TeiTeijin/EMF-Wire-Fault-Detector/firmware/EMF_Wire_Fault_Detector_v13/README.md

# Superseded firmware

This sketch version is kept for history only. It is **superseded by
[`EMF_Wire_Fault_Detector_v14`](../EMF_Wire_Fault_Detector_v14/)** —
do not flash this version.
