TeiTeijin/EMF-Wire-Fault-Detector/docs/erd.png

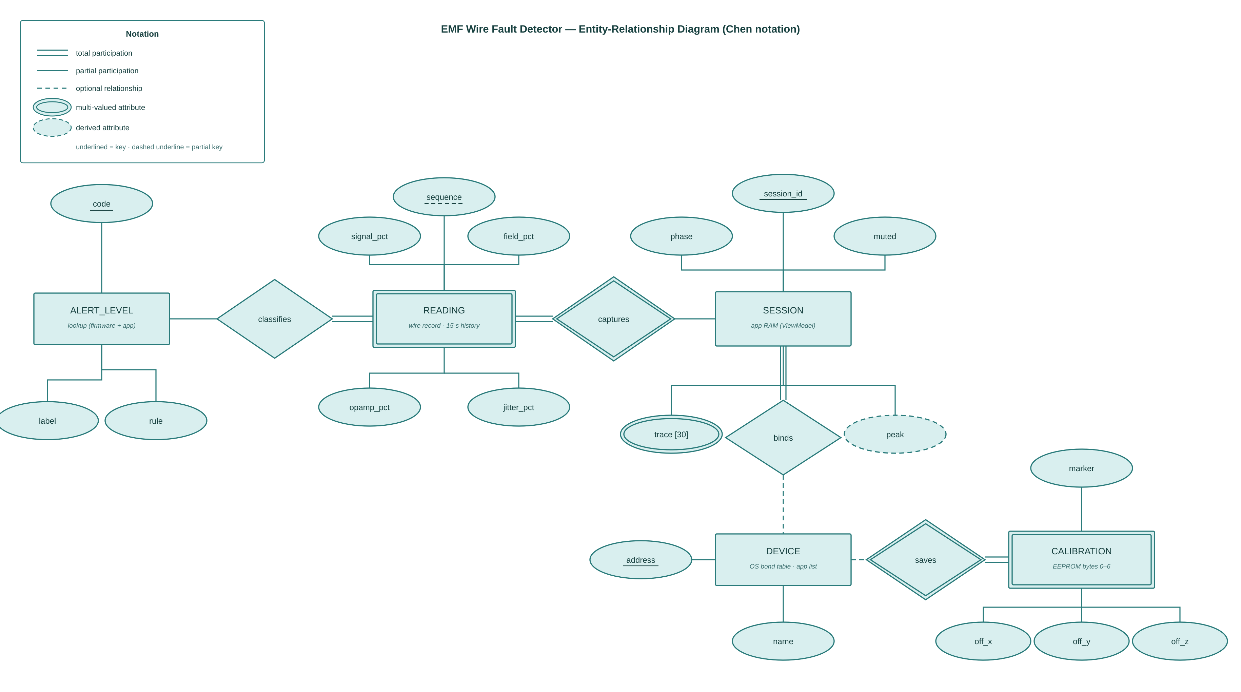
docs/erd.png
