TeiTeijin/EMF-Wire-Fault-Detector/docs/flowchart-firmware.png

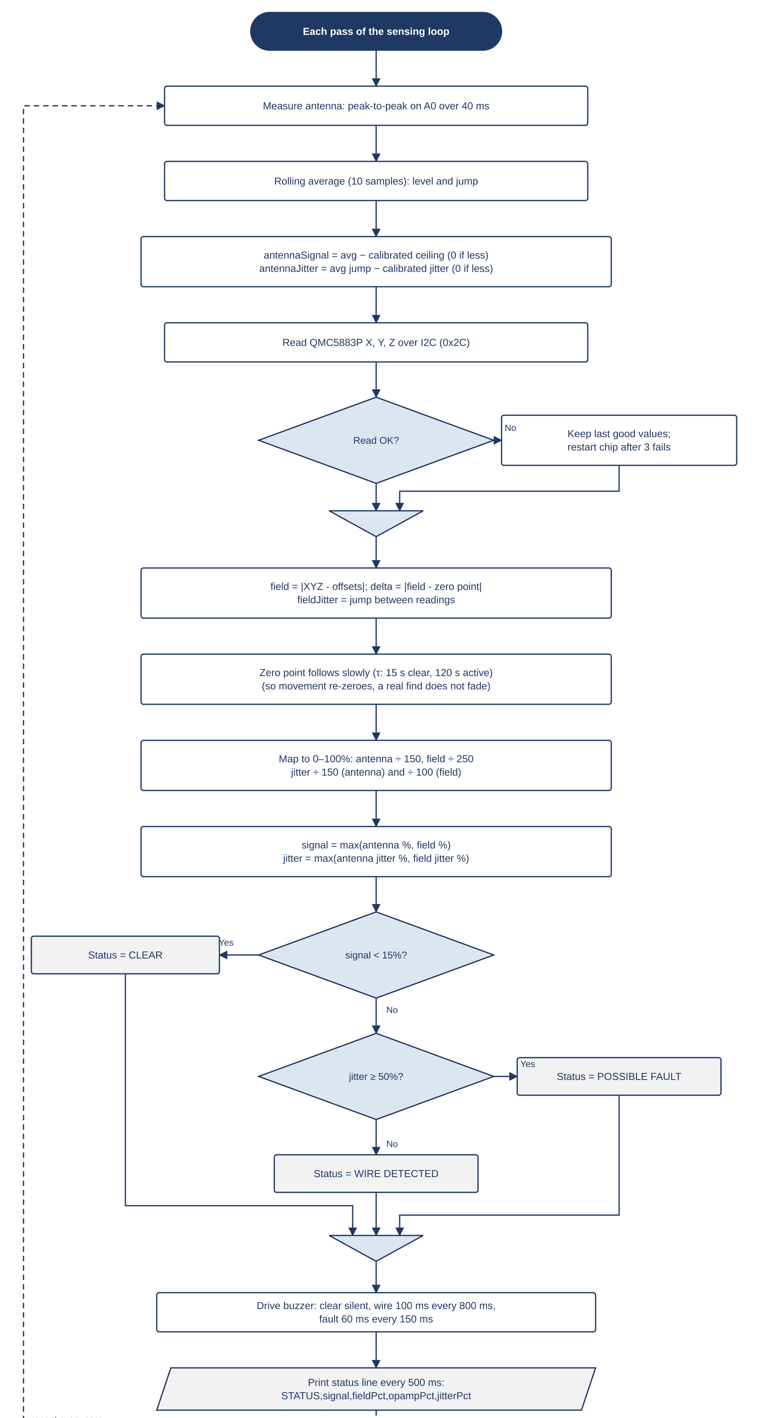
docs/flowchart-firmware.png
