TeiTeijin/EMF-Wire-Fault-Detector/docs/flowchart.png

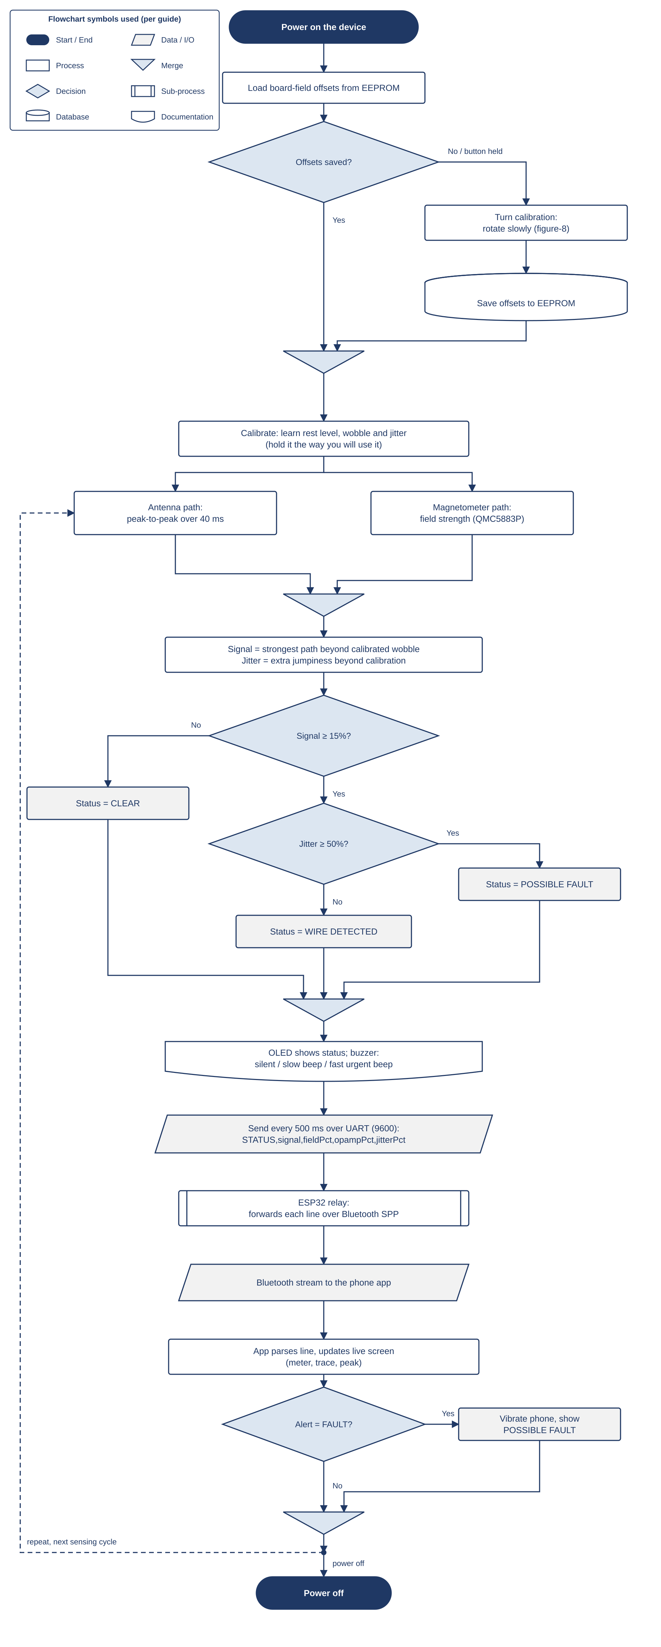
docs/flowchart.png
