TeiTeijin/EMF-Wire-Fault-Detector/docs/screenshots/01-bluetooth-access.png

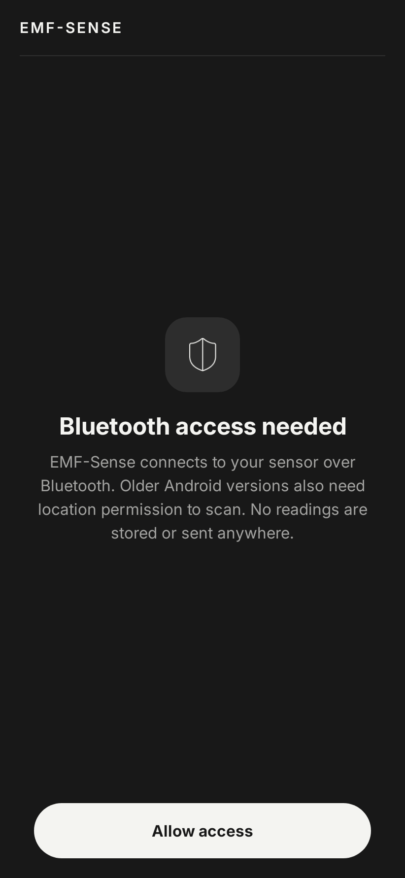
docs/screenshots/01-bluetooth-access.png
