TeiTeijin/EMF-Wire-Fault-Detector/docs/screenshots/02-bluetooth-denied.png

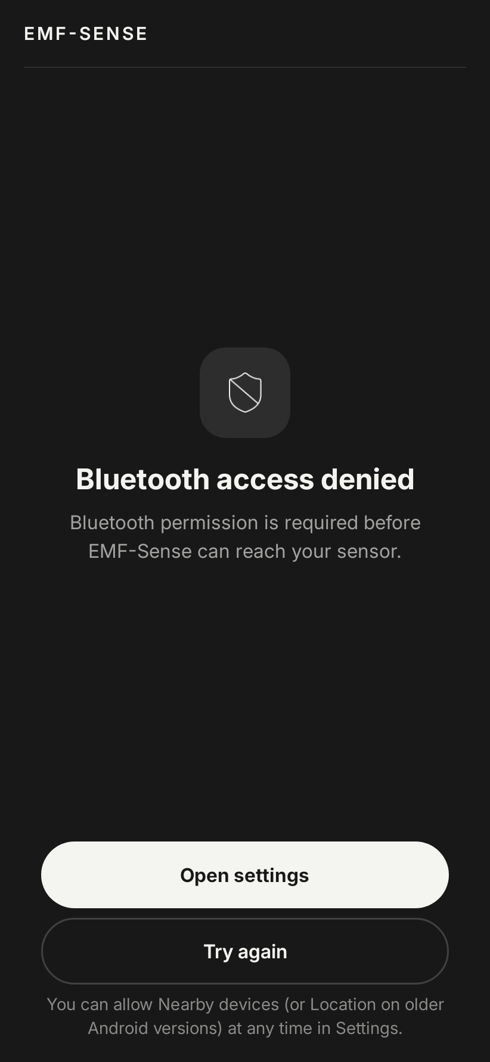
docs/screenshots/02-bluetooth-denied.png
