TeiTeijin/EMF-Wire-Fault-Detector/docs/screenshots/03-scan-loading.png

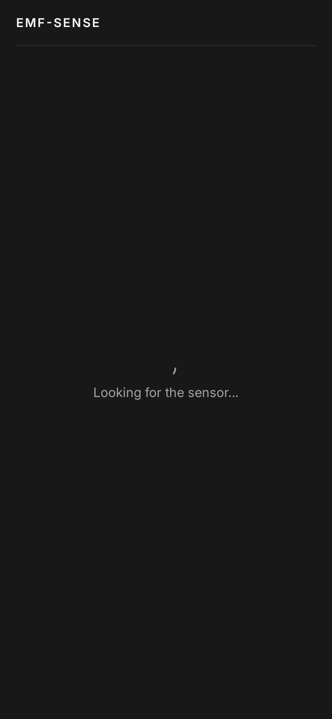
docs/screenshots/03-scan-loading.png
