TeiTeijin/EMF-Wire-Fault-Detector/docs/screenshots/04-scan-found.png

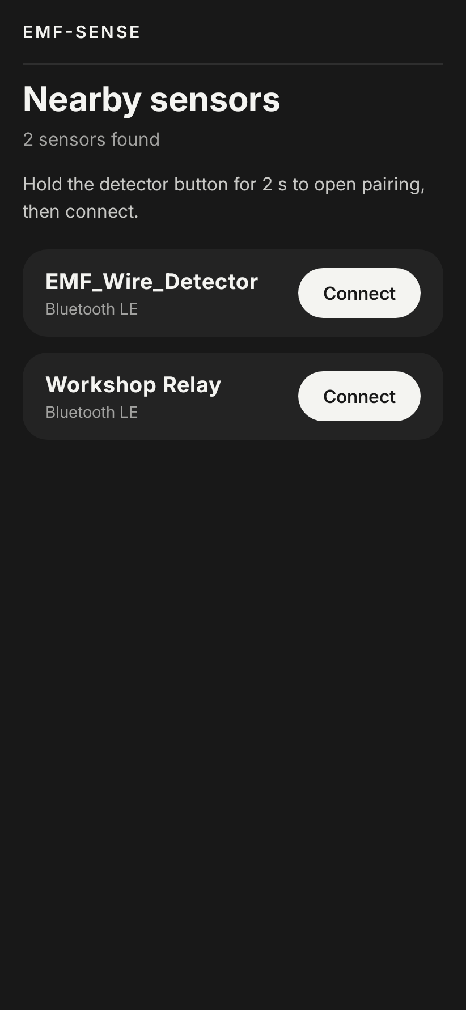
docs/screenshots/04-scan-found.png
