TeiTeijin/EMF-Wire-Fault-Detector/docs/screenshots/08-live-clear.png

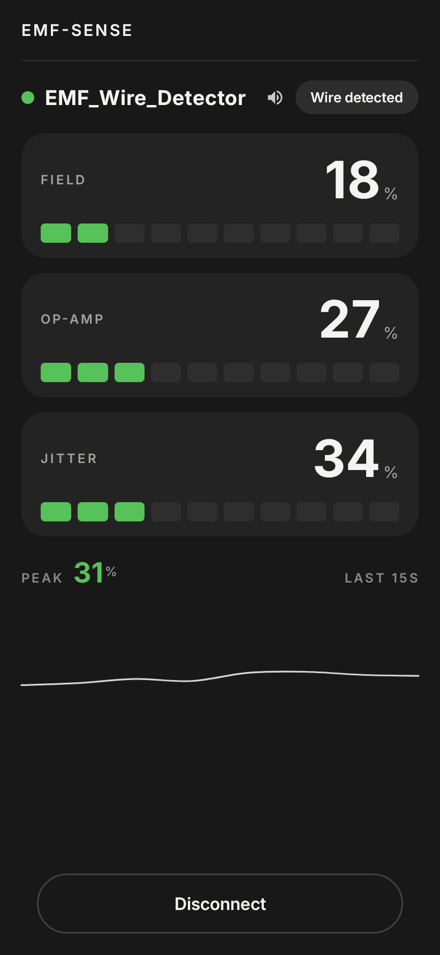
docs/screenshots/08-live-clear.png
