TeiTeijin/EMF-Wire-Fault-Detector/docs/screenshots/09-live-fault.png

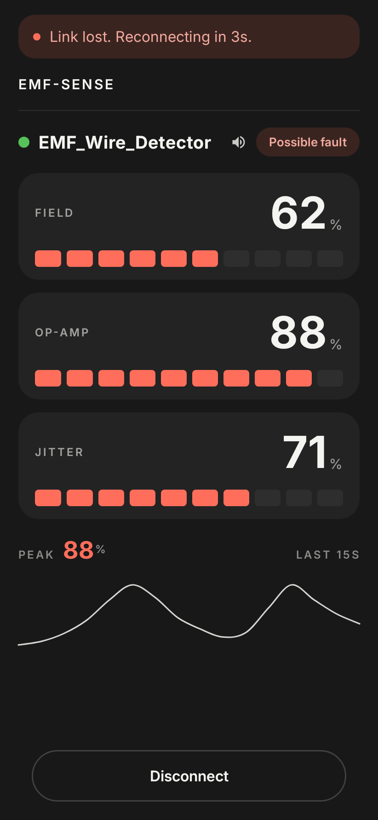
docs/screenshots/09-live-fault.png
