TeiTeijin/EMF-Wire-Fault-Detector/docs/screenshots/10-connection-failed.png

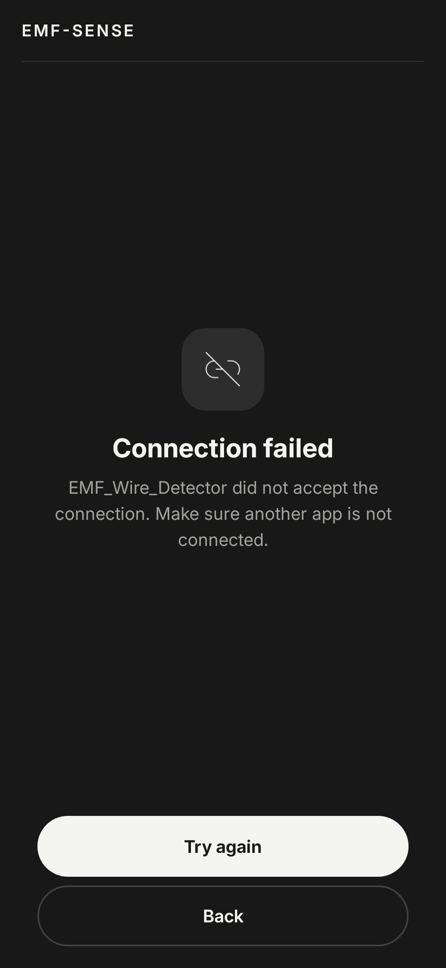
docs/screenshots/10-connection-failed.png
