TeiTeijin/EMF-Wire-Fault-Detector/(commit log)

2026-10-17 Initial commit: EMF Wire Fault Detector
    Complete capstone project with all three parts:
    - firmware/: Arduino Uno sketch (EMF_Wire_Fault_Detector_v11) - sensors,
    self-calibration, Clear/Wire/Fault classification, OLED, buzzer
    - backend/: ESP32 Bluetooth Classic SPP relay (ESP32_BT_Relay_2) that
    serves the Uno's serial stream to the phone
    - frontend/EMFReader: Android app EMF-SENSE (Kotlin + Jetpack Compose)
    with live readings, history trace, and alerts
    Includes README with architecture, wiring, protocol, and build steps.
    [ESP32_BT_Relay_2.ino]
2026-10-17 Add project documentation for the SIA1 submission
    - docs/api-specification.md — integration interface contract: Bluetooth
    SPP service, fixed-PIN authentication, message formats, timing limits,
    failure taxonomy, firmware compatibility matrix
    - docs/adr/ — five Architecture Decision Records (SPP link, two-board
    edge design, self-calibrating thresholds, handheld magnetometer
    approach, monorepo)
    - docs/validation-report.md — test plan with fillable results:
    performance, interoperability, reliability, low-voltage fault
    injection, plus known behaviours and limitations
    - docs/flowchart.svg + docs/flowchart-firmware.svg — flowcharts drawn
    with the submission guide's symbols, al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
2026-10-17 Add data schema and Chen-notation ERD
    - docs/erd.svg + docs/erd.png — entity-relationship diagram using the
    submission guide's symbols: weak entities (READING, CALIBRATION),
    identifying relationships (captures, saves), key / partial-key /
    multi-valued / derived attributes, total / partial / optional
    participation; orthogonal connectors, teal palette per the guide
    - docs/data-schema.md — data dictionary: the READING wire record, the
    ALERT_LEVEL lookup with its rules, SESSION state, DEVICE bond entry,
    CALIBRATION EEPROM byte layout, RAM-only calibration state, storage
    mapping and integrity rules (no RDBMS; logical model mapped to the
    real stores)
    - README: documentation tab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
2026-10-31 firmware: add v12 sketch (documented code, button debounce fix) and mark v11 superseded
2026-10-31 firmware: add v13 - automatic hard-iron calibration, softer movement response
2026-10-31 backend: ESP32 relay - BLE UART with static-passkey pairing window (replaces classic SPP)
    [ESP32_BT_Relay_2.ino]
2026-10-31 docs: BLE migration, ADRs 0006-0009 with superseded markers, updated specs and flowcharts
2026-10-31 firmware: fix missed button taps - sample the button at high rate inside the measurement window
    The button was polled once per loop (~150-300 ms), so quick taps shorter
    than a loop period fell between samples and were lost (users had to
    double-click). The debounce + press/hold classifier now live in a
    host-tested ButtonPoller fed inside the 40 ms measurement window.
    [EMF_Wire_Fault_Detector_v14.ino]
2026-10-31 firmware: capture button presses via 1 kHz Timer1 interrupt
    Polling the button in the main loop (even inside the measurement window)
    left gaps of up to ~300 ms while the loop was busy with I2C/display/serial,
    so quick taps fell between samples and were dropped. The button is now
    sampled by a Timer1 compare ISR at 1 kHz and classified on the release
    edge (EdgeButtonPoller, host-tested) - no tap can be missed, and a 2 s
    hold always reaches the pairing window. (Pin-change interrupts were not
    usable: SoftwareSerial owns the PCINT2 group.)
    [EMF_Wire_Fault_Detector_v14.ino, edgebutton.h, test_edgebutton.cpp]
2026-10-31 firmware: fire the pairing window at the 2 s hold mark (not on release)
    EdgeButtonPoller.tick() now latches LONG_HOLD while the button is still
    held at the 2 s mark, matching the promised UX (code appears without
    releasing); release after the mark fires nothing. Host tests updated and
    passing.
2026-10-31 firmware: software UART receiver on Timer2 replaces SoftwareSerial RX
    SoftwareSerial's receiver proved unreliable on this build (bytes never
    arrived, and a TX-RX loopback hung the MCU). The receive path is now a
    custom software UART: Timer2 samples D10 at 31.25 kHz and SoftUartRx
    (softuart.h, host-tested against simulated 9600-baud waveforms) decodes
    bytes with mid-bit sampling and a stop-bit sanity check. SoftwareSerial
    is now TX-only (D11) with a dummy RX pin. Also fixes: 100 Hz Timer1
    button sampling, LONG_HOLD fired at the 2 s mark, and UART moved to
    D10/D11 after a solder bridge shorted D2/D3 on this build.
    [EMF_Wire_Fault_Detector_v14.ino, softuart.h, test_softuart.cpp]
2026-10-31 backend+docs: relay UART2 TX on GPIO18, final wiring D10/D11 documented
2026-11-01 test: add a Roborazzi screenshot suite for every app screen
    Renders all 13 screens/states (permission gate, scan states, connecting,
    live clear/fault, failure, components) to PNGs in docs/screenshots with
    .\gradlew.bat :app:testDebugUnitTest - no device or emulator needed.
    Robolectric runs offline from a pre-downloaded android-all jar because
    its resolver mishandles the space in the Windows user profile path.
    [ScreenshotTest.kt]
2026-11-01 ui: apply the EMF-Sense redesign across every screen
    - New palette/typography: warmer background, filled surface cards, pill
    buttons, uppercase letter-spaced labels, sentence-case headings.
    - Live screen: reconnect banner above the wordmark, connected dot + status
    badge, metric cards with label/value header and 10-segment bar (coral in
    fault, green otherwise), peak row, smoothed sparkline, outlined
    disconnect pill.
    - Scan screen: 'Nearby sensors' header with count and pairing hint, filled
    device cards with 'Bluetooth LE' subtitle and pill Connect buttons.
    - Gate screens: icon in a rounded tile, sentence-case copy, full-width
    pill CTAs.
    - Refresh docs/screenshots for all 13 screen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
    [EmfSparkline.kt]
2026-11-01 backend: terminate relayed status lines with a newline
    The app's line parser only emits newline-terminated lines, so the relay
    must append '\n' to each BLE notification. Without it the app connected
    but never received a reading (6 s first-line timeout -> SILENT).
2026-11-02 firmware: reject handling motion and track the antenna baseline
    The op-amp channel was pinned at 0% because the calibration ceiling (max
    p2p) sat above the real operating level, while its jitter floor was learned
    during a quiet calibration and then exceeded in normal use. Replace the
    fixed ceiling with a slowly tracked antenna baseline (mean + margin), track
    the antenna jitter floor the same way, and hold a 5 s settle window after
    calibration so the baselines can converge before alerts are allowed.
    A single magnetometer cannot distinguish device motion from a field source.
    Gate the verdict to Clear while the field is strong and jumpy and the
    antenna is quiet (handling), holding it for 2.5 s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
    [EMF_Wire_Fault_Detector_v14.ino, classify.h, test_classify.cpp]
2026-11-02 firmware: hold the antenna baseline after a detection
    A steady live cord couples a constant hum into the antenna. With a 10 s
    baseline follower, an intermittent contact could fall below the alert
    threshold, be learned as the new resting level, and make the next touch
    look like no change. Slow the antenna follower to 60 s and freeze it for
    5 s after any detection (tracked as ah= in the debug line), so repeated
    touches keep registering while slow grip/body drift is still absorbed.
    [EMF_Wire_Fault_Detector_v14.ino]
2026-11-02 firmware: self-heal a frozen magnetometer, keep last good field
    The QMC5883P hangs (returns 0,0,0) and is not recovered by power cycling
    alone. Restart it after 8 frozen samples instead of 20, keep the last good
    field percentage on the OLED during a brief freeze, and only show Field ERR
    after the chip has been dead for 3 seconds. Never feed 0,0,0 triplets into
    the hard-iron learner. Keep the SET/RESET register at 0x08 (0x01 makes the
    chip hang continuously on this board).
    [EMF_Wire_Fault_Detector_v14.ino]
2026-11-04 firmware: freeze hard-iron offsets and tune for the defense demo
    Freeze the hard-iron offsets once they lock: continuous refinement was
    re-centering them during ordinary handling until the magnitude collapsed
    and the field channel went blind.
    Tune the demo behavior:
    - FIELD_MAX_DELTA 500 -> 75: a straight DC wire under the device now
    registers regardless of orientation.
    - Motion gate streak 8 -> 40: only ~12 s of continuous movement is
    suppressed; brief wire taps classify Wire/Fault first.
    Demo verified on serial: rattle -> FAULT (fieldPct 37-100, jitter 55-84),
    hold -> WIRE (17-29%, jitter <10), rest -> CLEAR, with the device resting
    on a straight DC conductor.
    [EMF_Wire_Fault_Detector_v14.ino, autocal.h]
